pravton/bottle-feed-logger/(commit log)

2026-06-04 Add Bottle Feed Logger: firmware + build guide
    A weighing bottle stand (ESP32 + 1 kg load cell + HX711 + SSD1306 OLED) that
    logs each feed's volume, time, and duration to a Notion database. Measures
    start-minus-end weight so the bottle cancels out (no per-bottle tare).
    Includes the PlatformIO firmware, a full step-by-step build guide, wiring /
    pinout / assembly notes, Notion integration setup, a bill of materials with
    buying guide, and an OpenSCAD starter for the 3D-printed stand.
    [bill-of-materials.csv, bottle-feed-logger-stand.scad]
2026-06-09 Add on-device Wi-Fi setup portal (WiFiManager)
    Replace the hard-coded WIFI_SSID/WIFI_PASSWORD connect with a captive-portal
    flow so the network can be changed without re-flashing — needed when the device
    moves between locations.
    - WiFiManager owns credentials in its own NVS: reconnects to the last network
    on boot, and only opens a "BottleFeedLogger-Setup" hotspot if that fails.
    - Hold the FEED button (D25) at boot to force the portal on demand (e.g. to
    switch networks). The forced portal has no timeout and stays up until a
    successful connect, so a typoed password keeps it open to retry. Plain-boot
    fallback is fast (~12s) since the device is portable.
    - OLED shows "Connecting to <S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
    [main.cpp]
2026-06-09 Add OTA (over-the-air) Wi-Fi firmware updates
    After this is flashed once over USB, future builds can be pushed over Wi-Fi with
    no cable, via the dedicated PlatformIO env:
    pio run -e ota -t upload
    The default esp32dev env stays on the serial uploader so USB flashing still works.
    - ArduinoOTA started once Wi-Fi is up; setupOTA() is idempotent and also called
    from the loop's health check, so OTA still starts if Wi-Fi connects after boot.
    - ArduinoOTA.handle() serviced in loop().
    - Optional OTA_PASSWORD (config.h): if set, OTA requires it (pass
    --upload-flags --auth=<password>); if unset, the firmware logs a warning, since
    open OTA lets anyone on the LAN push firmware.
    - OLED shows OTA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
2026-06-10 Address review: secure OTA by default, fix OTA auth docs
    - OTA is now DISABLED unless OTA_PASSWORD is set in config.h. Previously it
    started unauthenticated (with only a warning) when no password was defined,
    which let anyone on the LAN push arbitrary firmware (remote code execution).
    Requiring a password makes the secure path the default.
    - Fix the OTA auth instructions: `pio run` has no `--upload-flags` option. Use
    the `upload_flags = --auth=<password>` ini key in the [env:ota] block instead
    (added commented in platformio.ini; config.h.example updated to match).
    [main.cpp]
2026-06-10 Use an OTA-capable partition table (min_spiffs)
    OTA requires two app partitions (write the update to the inactive slot, then
    swap), but the build used huge_app.csv, which has a single app slot — so OTA
    authenticated and then failed at 0% every time. Switch to min_spiffs.csv
    (app0 + app1, ~1.9 MB each); the build is ~1.1 MB, so it fits with room to spare.
    Verified end-to-end: `pio run -e ota -t upload` now completes over Wi-Fi (100%,
    Result: OK) and the device reboots into the new firmware and reconnects.
2026-07-08 Port scale stability and on-device controls
    Brings firmware/src/main.cpp, config.h.example, and firmware/README.md
    up to date: median-filtered stable readings, signed calibration with
    rejection of bad calibrations, on-device tap/hold gestures (feed,
    tare, calibrate, restart, force Wi-Fi portal), a web control page
    gated by an optional WEB_CONTROL_KEY, and boot splash / connection
    screens. Verified with pio run (esp32dev + ota envs both build
    clean).
    [main.cpp]
2026-07-08 Address code review: safety guards, dead doc links, em dashes
    - Restart (TARE-hold gesture and web /restart) now refuses to fire
    while a feed is in progress, matching the existing tare/calibrate
    guards.
    - Web /cal/capture now requires a real, steady load (matching the
    on-device CAL_MIN_LOAD_COUNTS check) and a tightened weight bound
    (10-2000 g) instead of accepting an empty platform as valid.
    - Added NVS load validation for the saved reference weight, matching
    the existing calibration-factor validation.
    - Fixed two dead docs/design-decisions.md references and a misleading
    comment about what WEB_CONTROL_KEY actually protects.
    - Removed em dashes from comments and docs per repo sty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
    [main.cpp]
2026-07-08 Fix remaining dead doc reference from second Copilot pass
    The setInsecure() comment still pointed at docs/design-decisions.md,
    which doesn't exist in this repo; point it at the TLS note in
    firmware/README.md instead.
    [main.cpp]
2026-10-14 Re-zero scale at boot instead of restoring a stale offset; enable OTA
    The boot path restored the saved tareOffset from NVS verbatim. An HX711's
    zero-load raw reading drifts across power cycles (temperature, mechanical
    settling after travel), so replaying an old zero showed a phantom 400-500 g
    on an empty platform after a reboot in a new place, and only a recalibration
    (whose first step is itself a tare) cleared it.
    setup() now always re-zeros via tareRobust() at boot, using the saved offset
    only as a fallback when the HX711 isn't readable yet. tareRobust() returns
    bool to drive that fallback. The calibration factor (span) is still persisted
    since it is stable across boots; only the zero is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
2026-10-14 Reject calibration when the load deflection is too small
    The web /cal/capture path only waited for stability, not for a real load,
    then handed any non-zero delta to applyCalibration(). A barely-responding
    or unmounted cell could thus persist an absurd factor (observed: 2.1
    counts/gram from a 296-count delta on a 141 g weight). A tiny counts/gram
    amplifies normal sensor noise into tens of grams, so taring appears not to
    work: you zero it and it drifts straight back.
    applyCalibration() now rejects |delta| < CAL_MIN_LOAD_COUNTS before deriving
    a factor, matching the floor the on-device flow already enforces via
    waitStableLoaded(). Both calibration paths now refuse a too-small deflection
    instea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
2026-10-14 Bring the OTA and upload instructions in line with the new config
    config.h.example still said to uncomment an upload_flags line in
    platformio.ini, but the OTA password is now read from the OTA_PASSWORD
    environment variable and that line is always active. It now says to export
    the password before an OTA upload.
    The one-off USB upload example in platformio.ini now names the esp32dev env.
    Without -e, PlatformIO tries both envs and the OTA one fails on a serial port.
2026-10-14 Act on a failed tare instead of carrying on as if it worked
    tareRobust() now reports success, and three callers ignored it.
    On-device calibration went straight on after a failed zero, measuring against
    the previous offset. That offset can be the stale zero from before a reboot,
    which looks like a real load, so a wrong factor could be saved. It now cancels.
    The web Tare and Zero buttons answered with success either way. They now
    return an error when the tare fails, and the page's Zero step only ticks when
    the device confirms it.
    If the HX711 can't be read at boot, the saved zero is still used as a
    stopgap, but loop() now retries the tare once the scale responds, only while
    idle and at most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
